siredmar/bbb_cnc/README.md

bbb_cnc
=======

Beaglebone Black Cape for CNC machines
