siredmar/bbb_cnc/hw/BBB_CNC_V3.brd

## EAGLE design hw/BBB_CNC_V3.brd (2014-07-09)

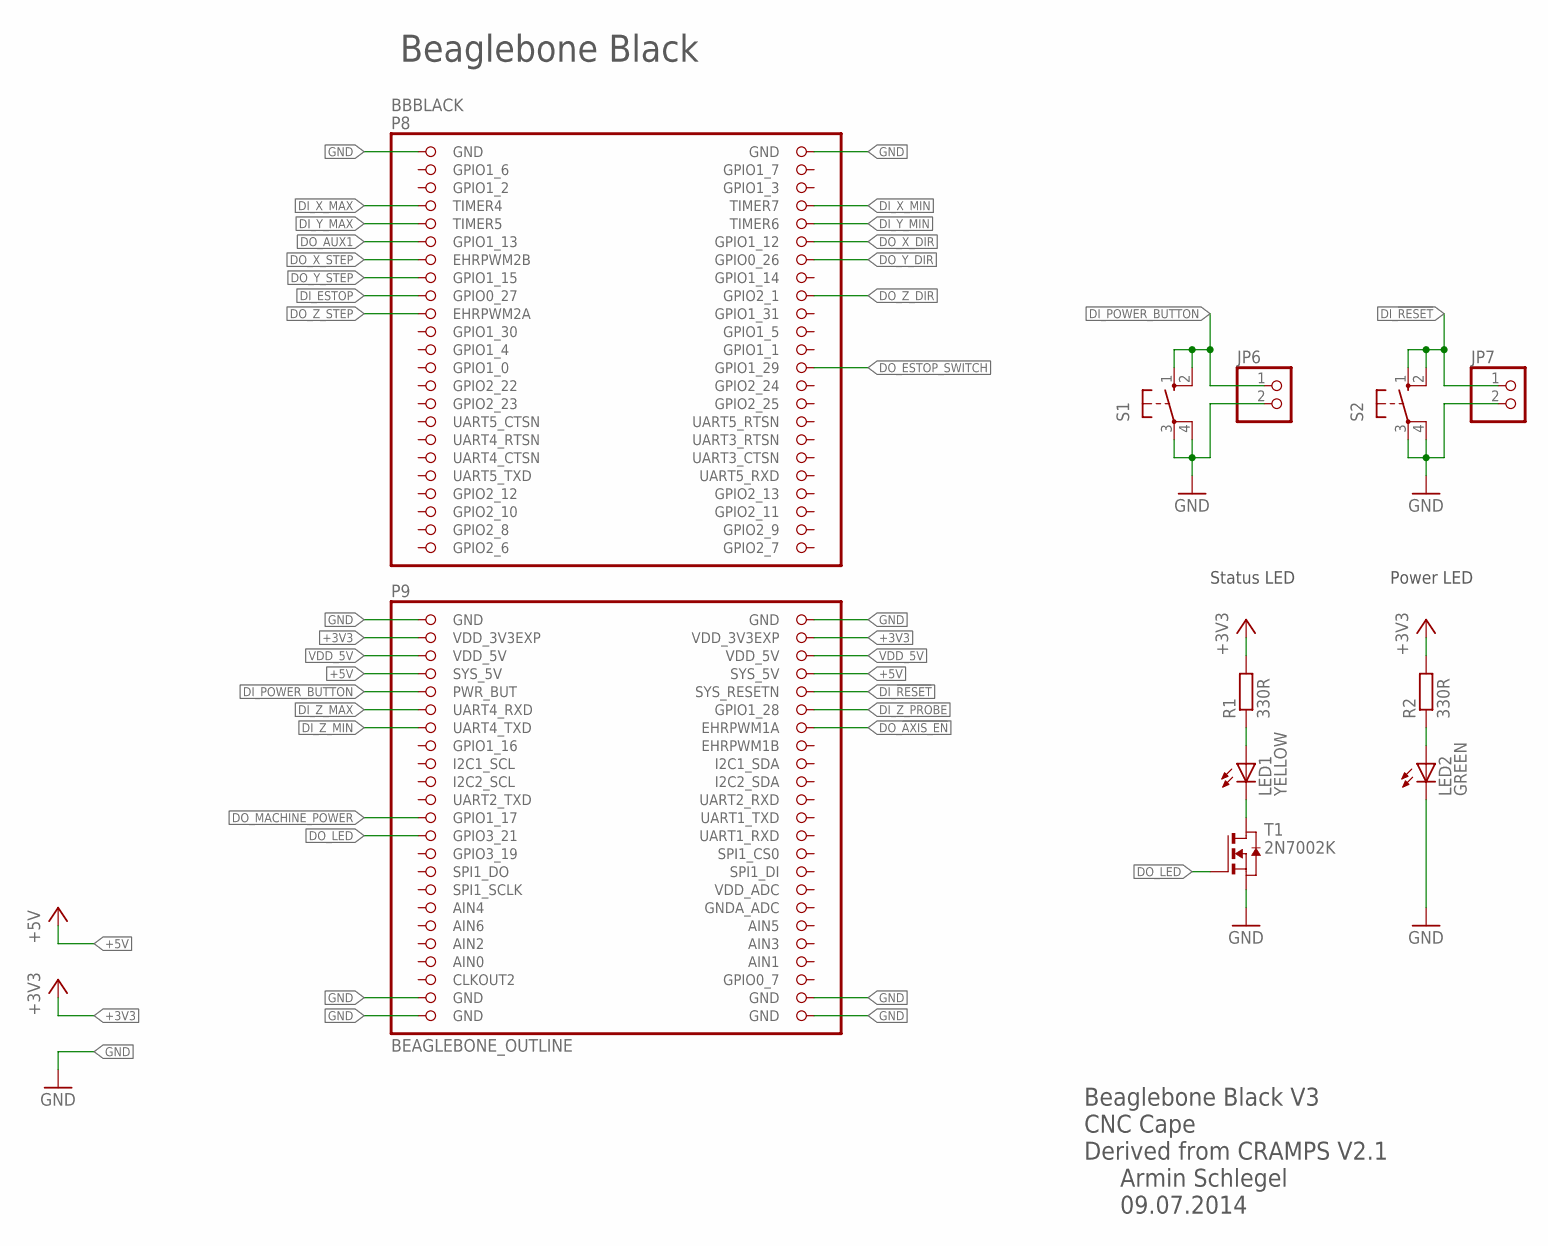
[picture p1: schematic BBB_CNC_V3.sch, sheet 1]

Parts:
BBBLACK: BEAGLEBONE_OUTLINE; BEAGLEBONE_SHIELD
JP6, JP7: PINHD-1X2; 1X02
LED1: YELLOW; SML0805
LED2: GREEN; SML0805
R1, R2: 330R; R0603
S1, S2: 10-XX; B3F-10XX
T1: 2N7002K; SOT-23

Connections:
+3V3: BBBLACK.49 (VDD_3V3EXP), BBBLACK.50 (VDD_3V3EXP), R1.2, R2.2; also elsewhere on the board
+5V: BBBLACK.53 (SYS_5V), BBBLACK.54 (SYS_5V); also elsewhere on the board
AIN0: BBBLACK.85 (AIN0)
DI_!RESET: BBBLACK.56 (SYS_RESETN), JP7.1, S2.1 (S), S2.2 (S1)
DI_ESTOP: BBBLACK.17 (GPIO0_27); also elsewhere on the board
DI_POWER_BUTTON: BBBLACK.55 (PWR_BUT), JP6.1, S1.1 (S), S1.2 (S1)
DI_X_MAX: BBBLACK.7 (TIMER4); also elsewhere on the board
DI_X_MIN: BBBLACK.8 (TIMER7); also elsewhere on the board
DI_Y_MAX: BBBLACK.9 (TIMER5); also elsewhere on the board
DI_Y_MIN: BBBLACK.10 (TIMER6); also elsewhere on the board
DI_Z_MAX: BBBLACK.57 (UART4_RXD); also elsewhere on the board
DI_Z_MIN: BBBLACK.59 (UART4_TXD); also elsewhere on the board
DI_Z_PROBE: BBBLACK.58 (GPIO1_28); also elsewhere on the board
DO_!AXIS_EN: BBBLACK.60 (EHRPWM1A); also elsewhere on the board
DO_AUX1: BBBLACK.11 (GPIO1_13); also elsewhere on the board
DO_ESTOP_SWITCH: BBBLACK.26 (GPIO1_29); also elsewhere on the board
DO_LED: BBBLACK.71 (GPIO3_21), T1.3 (G)
DO_MACHINE_POWER: BBBLACK.69 (GPIO1_17); also elsewhere on the board
DO_X_DIR: BBBLACK.12 (GPIO1_12); also elsewhere on the board
DO_X_STEP: BBBLACK.13 (EHRPWM2B); also elsewhere on the board
DO_Y_DIR: BBBLACK.14 (GPIO0_26); also elsewhere on the board
DO_Y_STEP: BBBLACK.15 (GPIO1_15); also elsewhere on the board
DO_Z_DIR: BBBLACK.18 (GPIO2_1); also elsewhere on the board
DO_Z_STEP: BBBLACK.19 (EHRPWM2A); also elsewhere on the board
GND: BBBLACK.1 (GND), BBBLACK.2 (GND), BBBLACK.47 (GND), BBBLACK.48 (GND), BBBLACK.89 (GND), BBBLACK.90 (GND), BBBLACK.91 (GND), BBBLACK.92 (GND), JP6.2, JP7.2, LED2.C, S1.3, S1.4 (P1), S2.3, S2.4 (P1), T1.2 (S); also elsewhere on the board
unnamed: LED1.C, T1.1 (D)
unnamed: LED1.A, R1.1
unnamed: LED2.A, R2.1
VDD_5V: BBBLACK.51 (VDD_5V), BBBLACK.52 (VDD_5V)

Notes on the sheet:
Status LED
Power LED
Beaglebone Black
Beaglebone Black V3 CNC Cape Derived from CRAMPS V2.1
Armin Schlegel 09.07.2014

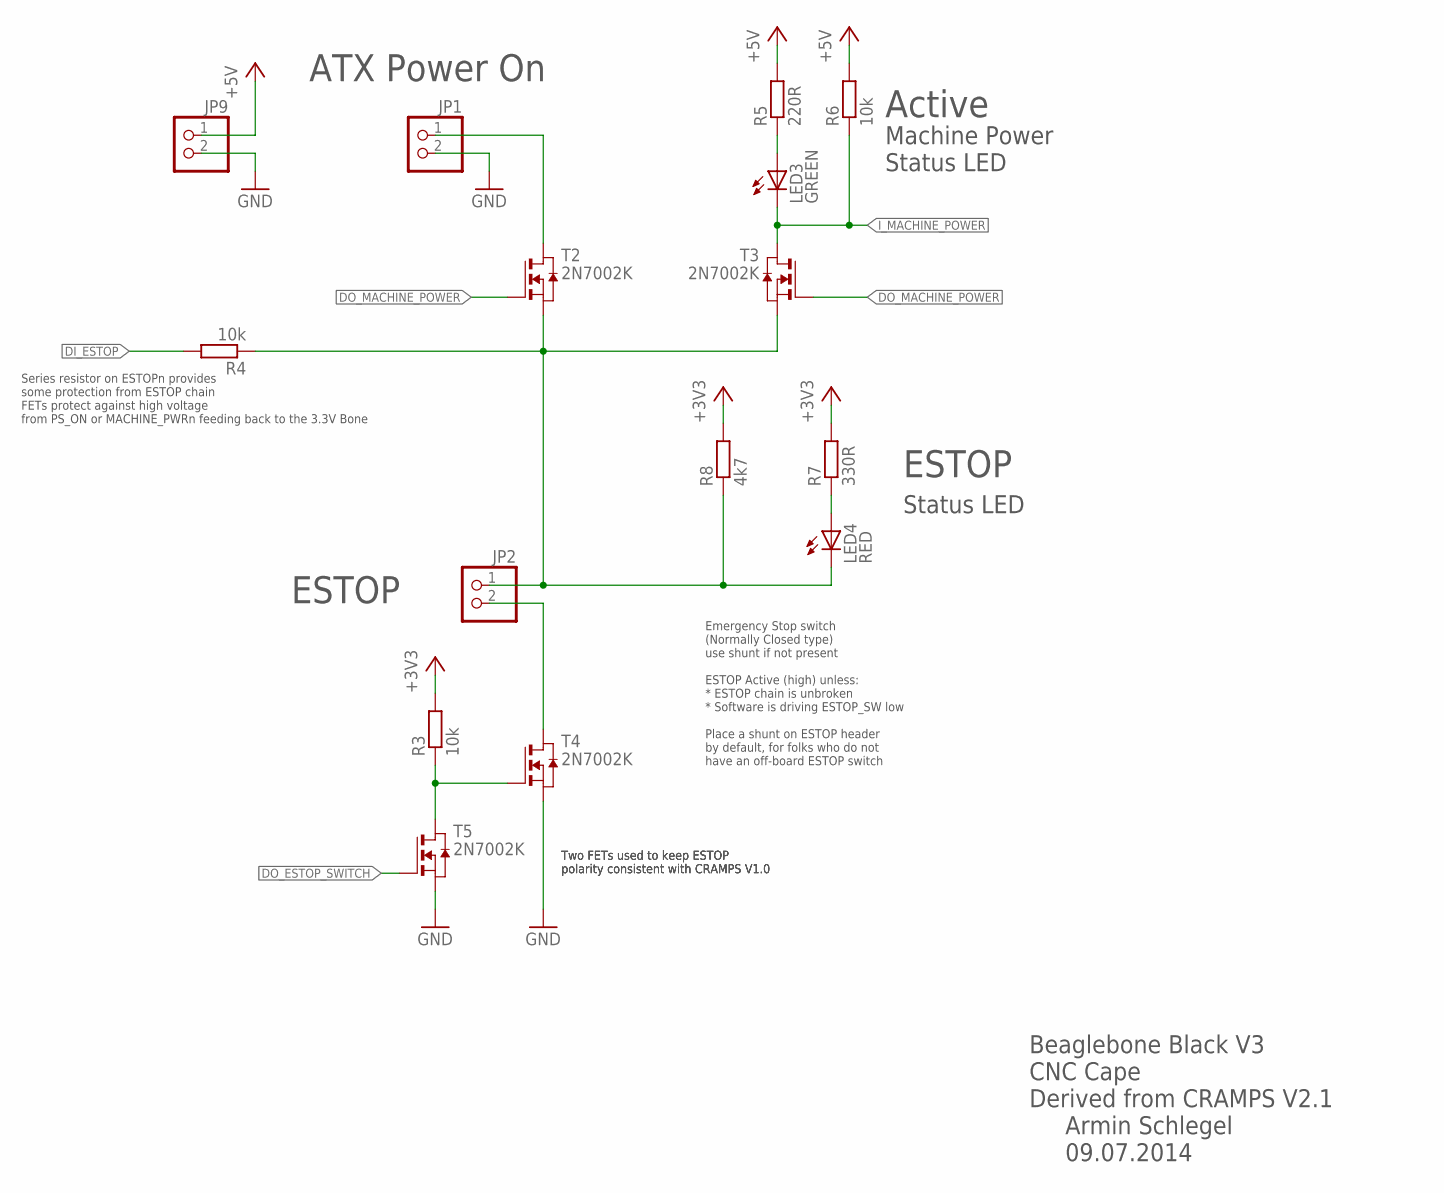
[picture p2: schematic BBB_CNC_V3.sch, sheet 2]

Parts:
JP1, JP2, JP9: PINHD-1X2; 1X02
LED3: GREEN; SML0805
LED4: RED; SML0805
R3, R4, R6: 10k; R0603
R5: 220R; R0603
R7: 330R; R0603
R8: 4k7; R0603
T2, T3, T4, T5: 2N7002K; SOT-23

Connections:
+3V3: R3.2, R7.2, R8.2; also elsewhere on the board
+5V: JP9.1, R5.2, R6.2; also elsewhere on the board
DI_ESTOP: R4.2; also elsewhere on the board
DO_ESTOP_SWITCH: T5.3 (G); also elsewhere on the board
DO_MACHINE_POWER: T2.3 (G), T3.3 (G); also elsewhere on the board
GND: JP1.2, JP9.2, T4.2 (S), T5.2 (S); also elsewhere on the board
I_MACHINE_POWER: LED3.C, R6.1, T3.1 (D); also elsewhere on the board
I_MACHINE_POWER1: JP2.1, LED4.C, R4.1, R8.1, T2.2 (S), T3.2 (S)
unnamed: JP1.1, T2.1 (D)
unnamed: R3.1, T4.3 (G), T5.1 (D)
unnamed: JP2.2, T4.1 (D)
unnamed: LED3.A, R5.1
unnamed: LED4.A, R7.1

Notes on the sheet:
Series resistor on ESTOPn provides some protection from ESTOP chain FETs protect against high voltage from PS_ON or MACHINE_PWRn feeding back to the 3.3V Bone
ATX Power On
Active
Two FETs used to keep ESTOP polarity consistent with CRAMPS V1.0
Emergency Stop switch (Normally Closed type) use shunt if not present
ESTOP Active (high) unless: * ESTOP chain is unbroken * Software is driving ESTOP_SW low
Place a shunt on ESTOP header by default, for folks who do not have an off-board ESTOP switch
ESTOP
Status LED
Machine Power Status LED
Beaglebone Black V3 CNC Cape Derived from CRAMPS V2.1
Armin Schlegel 09.07.2014

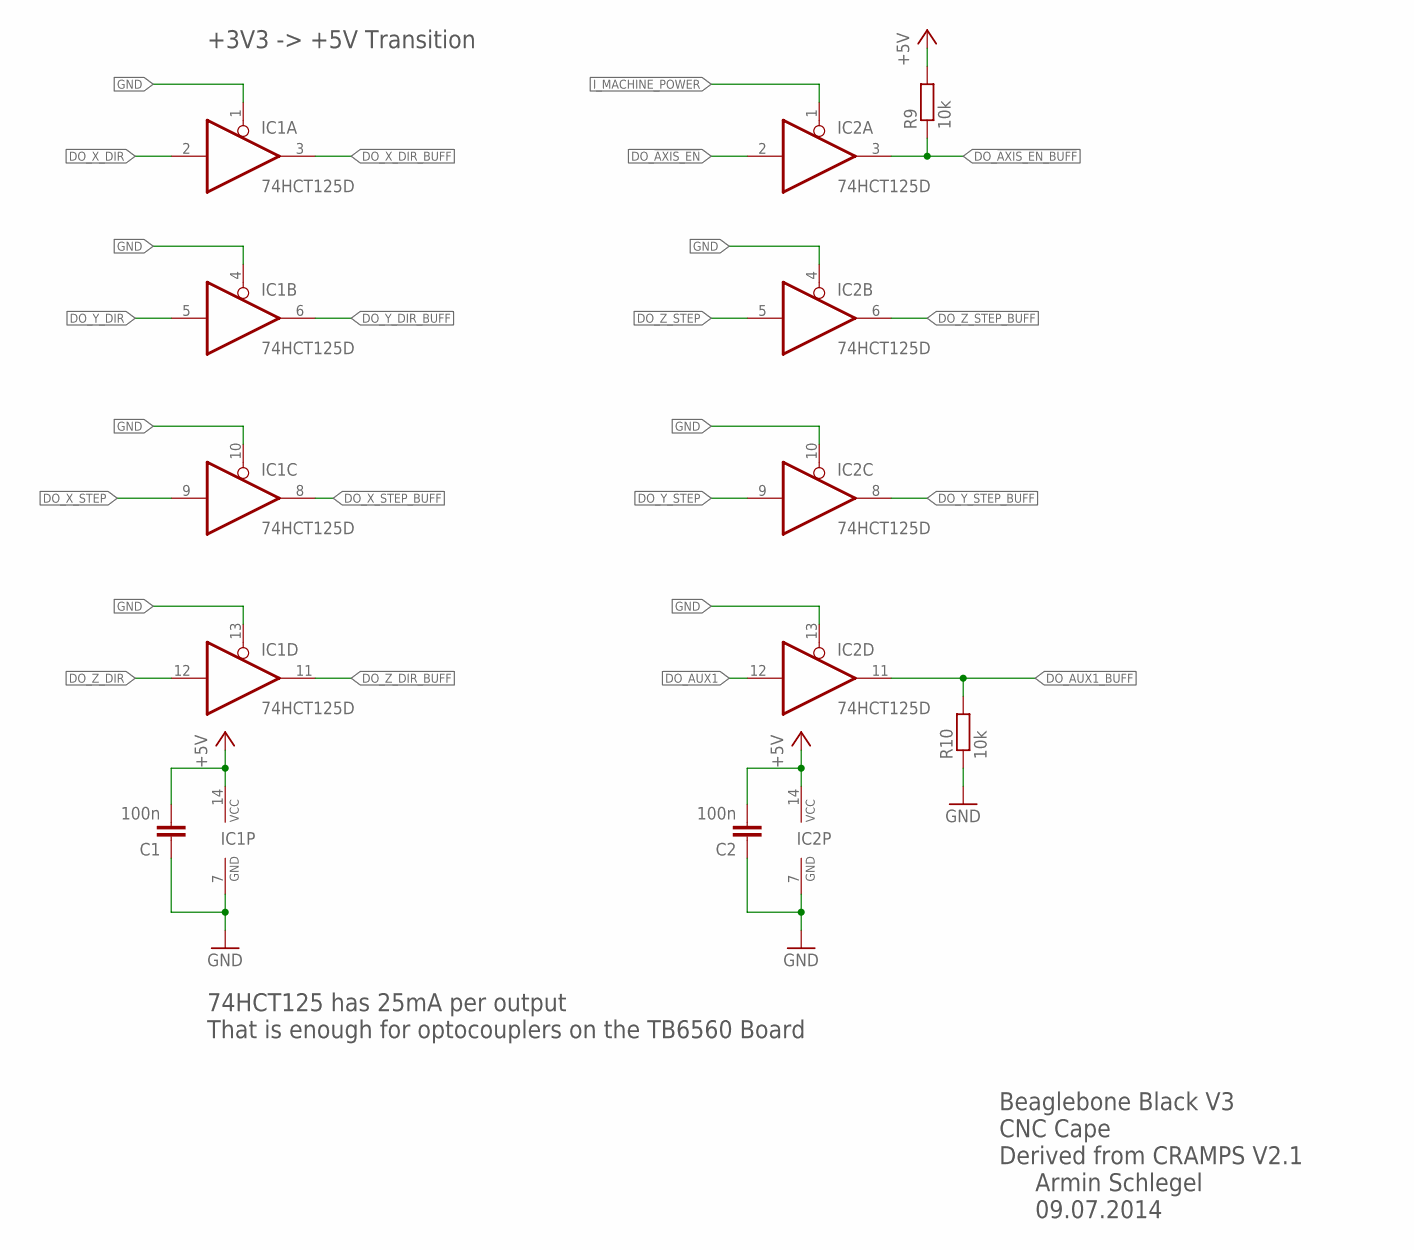
[picture p3: schematic BBB_CNC_V3.sch, sheet 3]

Parts:
C1, C2: 100n; C0603K
IC1, IC2: 74HCT125D; SO14
R9, R10: 10k; R0603

Connections:
+5V: C1.2, C2.2, IC1.14 (VCC), IC2.14 (VCC), R9.2; also elsewhere on the board
DO_!AXIS_EN: IC2.2 (I); also elsewhere on the board
DO_!AXIS_EN_BUFF: IC2.3 (O), R9.1; also elsewhere on the board
DO_AUX1: IC2.12 (I); also elsewhere on the board
DO_AUX1_BUFF: IC2.11 (O), R10.2; also elsewhere on the board
DO_X_DIR: IC1.2 (I); also elsewhere on the board
DO_X_DIR_BUFF: IC1.3 (O); also elsewhere on the board
DO_X_STEP: IC1.9 (I); also elsewhere on the board
DO_X_STEP_BUFF: IC1.8 (O); also elsewhere on the board
DO_Y_DIR: IC1.5 (I); also elsewhere on the board
DO_Y_DIR_BUFF: IC1.6 (O); also elsewhere on the board
DO_Y_STEP: IC2.9 (I); also elsewhere on the board
DO_Y_STEP_BUFF: IC2.8 (O); also elsewhere on the board
DO_Z_DIR: IC1.12 (I); also elsewhere on the board
DO_Z_DIR_BUFF: IC1.11 (O); also elsewhere on the board
DO_Z_STEP: IC2.5 (I); also elsewhere on the board
DO_Z_STEP_BUFF: IC2.6 (O); also elsewhere on the board
GND: C1.1, C2.1, IC1.1 (OE), IC1.4 (OE), IC1.7 (GND), IC1.10 (OE), IC1.13 (OE), IC2.4 (OE), IC2.7 (GND), IC2.10 (OE), IC2.13 (OE), R10.1; also elsewhere on the board
I_MACHINE_POWER: IC2.1 (OE); also elsewhere on the board

Notes on the sheet:
+3V3 -> +5V Transition
74HCT125 has 25mA per output That is enough for optocouplers on the TB6560 Board
Beaglebone Black V3 CNC Cape Derived from CRAMPS V2.1
Armin Schlegel 09.07.2014

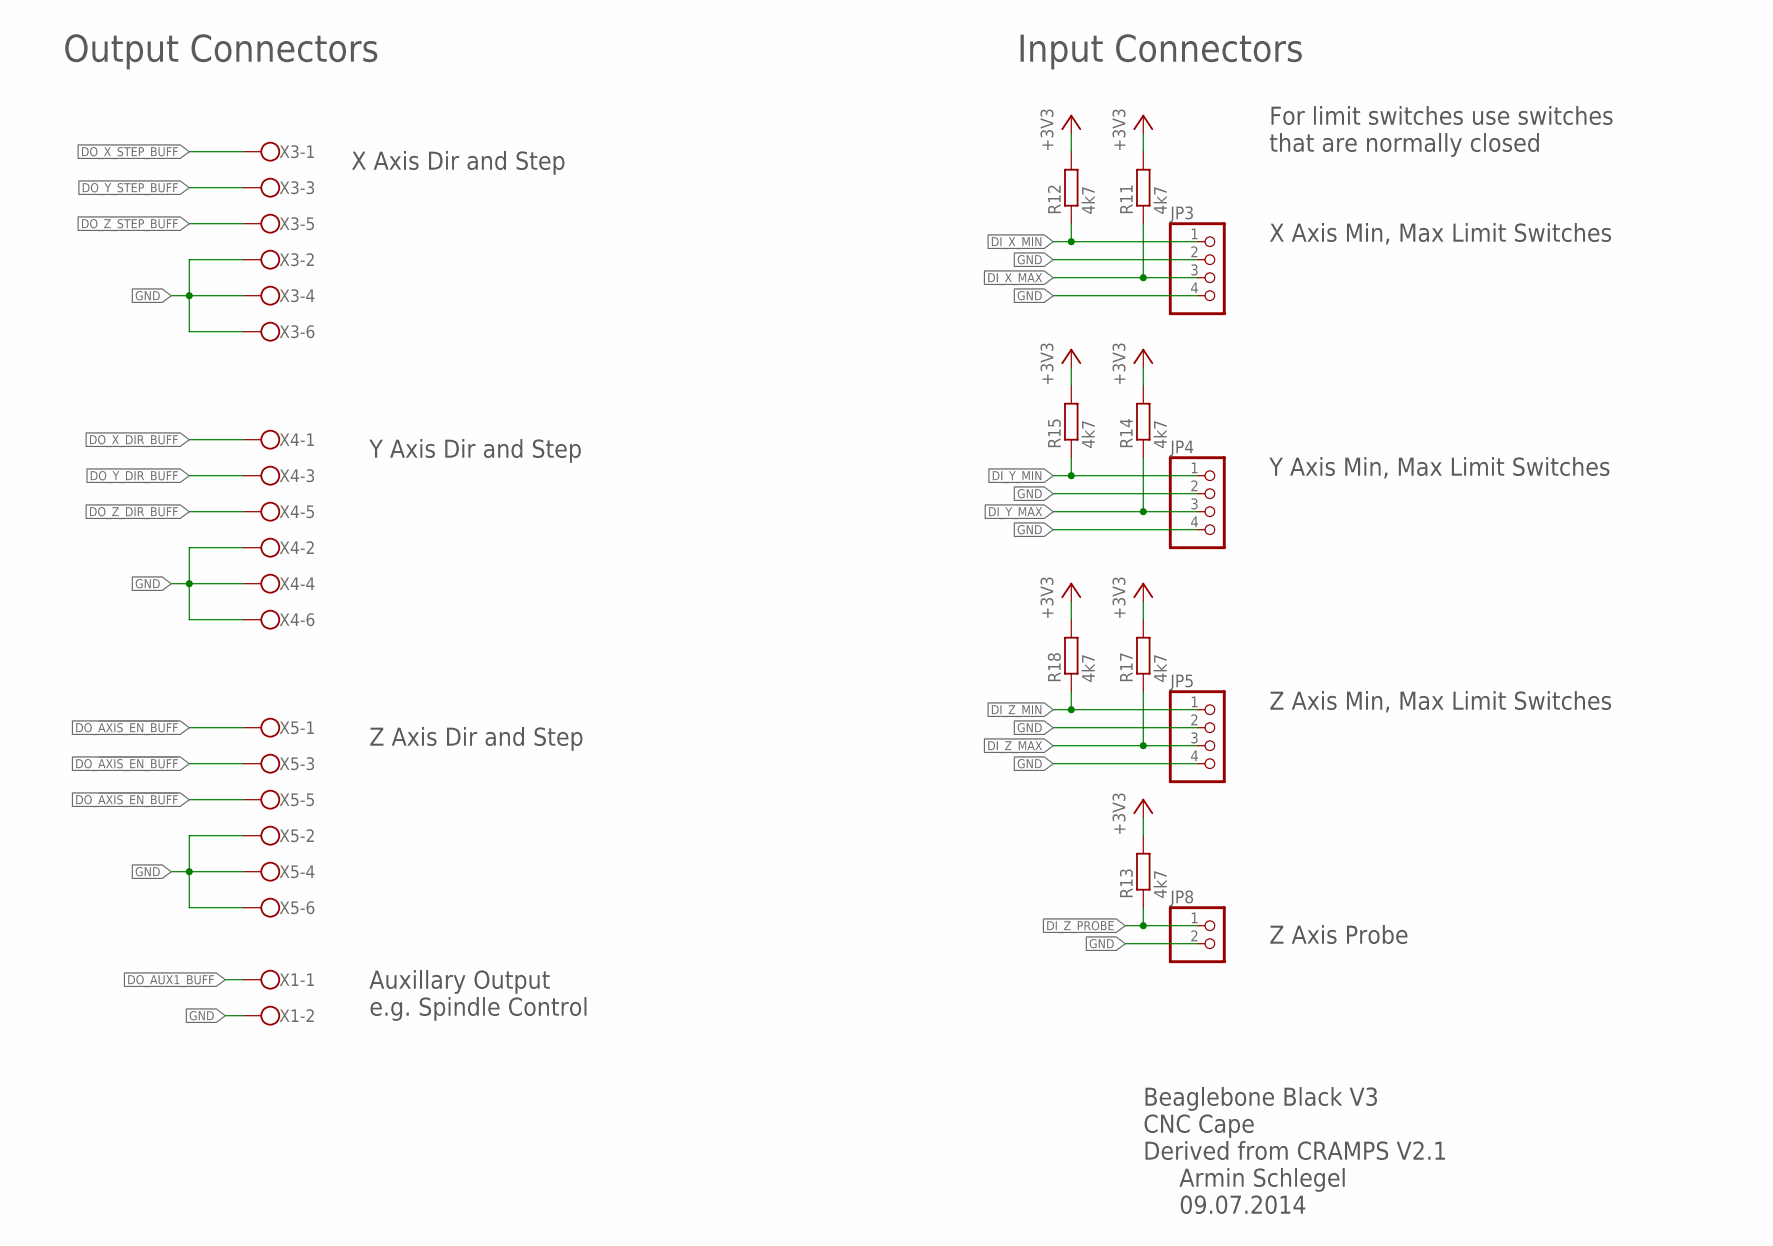
[picture p4: schematic BBB_CNC_V3.sch, sheet 4]

Parts:
JP3, JP4, JP5: PINHD-1X4; 1X04
JP8: PINHD-1X2; 1X02
R11, R12, R13, R14, R15, R17, R18: 4k7; R0603
X1: W237-102
X3, X4, X5: W237-136

Connections:
+3V3: R11.2, R12.2, R13.2, R14.2, R15.2, R17.2, R18.2; also elsewhere on the board
DI_X_MAX: JP3.3, R11.1; also elsewhere on the board
DI_X_MIN: JP3.1, R12.1; also elsewhere on the board
DI_Y_MAX: JP4.3, R14.1; also elsewhere on the board
DI_Y_MIN: JP4.1, R15.1; also elsewhere on the board
DI_Z_MAX: JP5.3, R17.1; also elsewhere on the board
DI_Z_MIN: JP5.1, R18.1; also elsewhere on the board
DI_Z_PROBE: JP8.1, R13.1; also elsewhere on the board
DO_!AXIS_EN_BUFF: X5.1, X5.3, X5.5; also elsewhere on the board
DO_AUX1_BUFF: X1.1; also elsewhere on the board
DO_X_DIR_BUFF: X4.1; also elsewhere on the board
DO_X_STEP_BUFF: X3.1; also elsewhere on the board
DO_Y_DIR_BUFF: X4.3; also elsewhere on the board
DO_Y_STEP_BUFF: X3.3; also elsewhere on the board
DO_Z_DIR_BUFF: X4.5; also elsewhere on the board
DO_Z_STEP_BUFF: X3.5; also elsewhere on the board
GND: JP3.2, JP3.4, JP4.2, JP4.4, JP5.2, JP5.4, JP8.2, X1.2, X3.2, X3.4, X3.6, X4.2, X4.4, X4.6, X5.2, X5.4, X5.6; also elsewhere on the board

Notes on the sheet:
Output Connectors
Input Connectors
X Axis Dir and Step
Y Axis Dir and Step
Z Axis Dir and Step
Z Axis Probe
X Axis Min, Max Limit Switches
Y Axis Min, Max Limit Switches
Z Axis Min, Max Limit Switches
Auxillary Output e.g. Spindle Control
For limit switches use switches that are normally closed
Beaglebone Black V3 CNC Cape Derived from CRAMPS V2.1
Armin Schlegel 09.07.2014

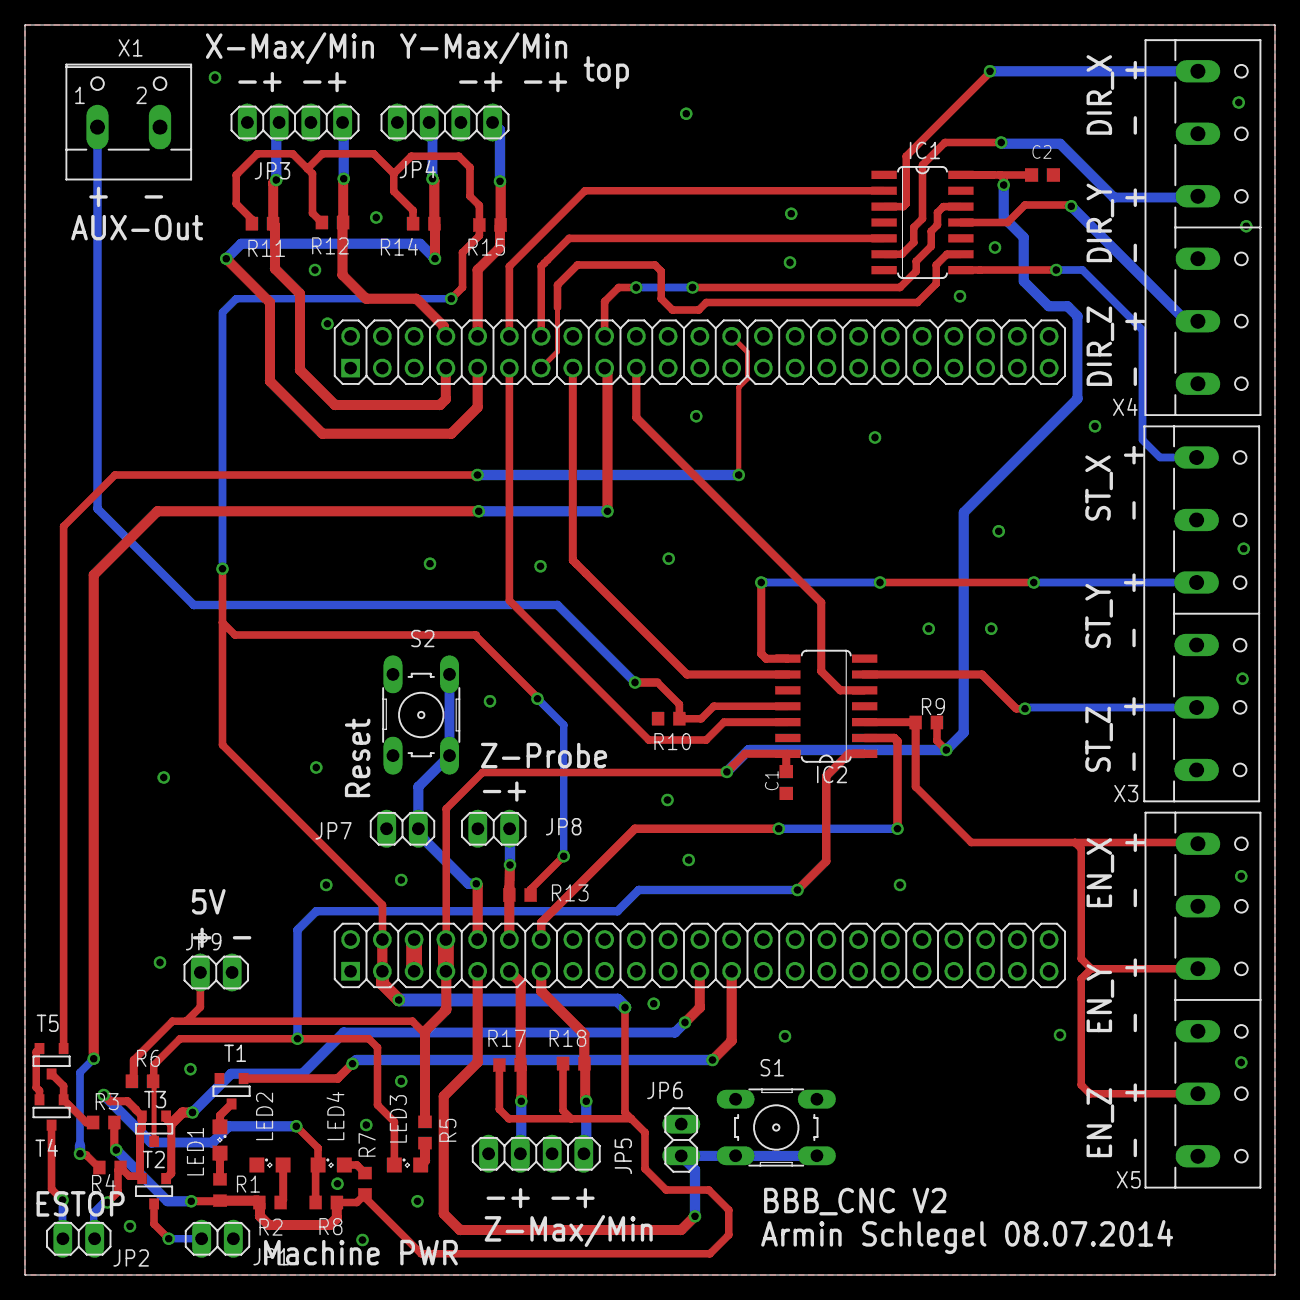
[picture p5: board BBB_CNC_V3.brd from above]

Board: 2 copper layers, 100.0 x 100.0 mm, 46 parts (0 on the bottom side), 43 nets.
