siredmar/bbb_cnc/(commit log)

2014-07-03 repo initialized
    [BBB_CNC.sch]
2014-07-04 version 1 of schematic finished
    [BBB_CNC.brd]
2014-07-04 deleted backup files
    [BBB_CNC.brd]
2014-07-06 modified v1, finished pcb
    [BBB_CNC.brd, BBB_CNC.sch]
2014-07-08 V2, gerber files for Itead
    [BBB_CNC.GBL, BBB_CNC.GBO, BBB_CNC.GBP, BBB_CNC.GBS, BBB_CNC.GTL, BBB_CNC.GTO, BBB_CNC.GTP, BBB_CNC.GTS]
2014-07-08 added zip for itead containing gerber file
    [BBB_CNC.GKO]
2014-07-09 corrected error on v2 -> v3
    [BBB_CNC_V2.brd, BBB_CNC_V2.sch, BBB_CNC_V3.brd, BBB_CNC_V3.sch]
2014-07-09 updated gerber files to V3
    [BBB_CNC_V3.GBL, BBB_CNC_V3.GBO, BBB_CNC_V3.GBP, BBB_CNC_V3.GBS, BBB_CNC_V3.GKO, BBB_CNC_V3.GTL, BBB_CNC_V3.GTO, BBB_CNC_V3.GTP]
2014-07-30 received pcbs from itead
